aheinous/usb_hexaphonic_soundcard/media/PCB_top_1.png

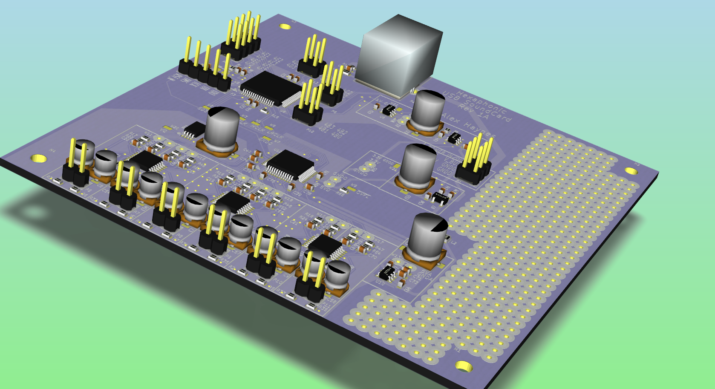
media/PCB_top_1.png
