aheinous/usb_hexaphonic_soundcard/media/PCB_bottom.png

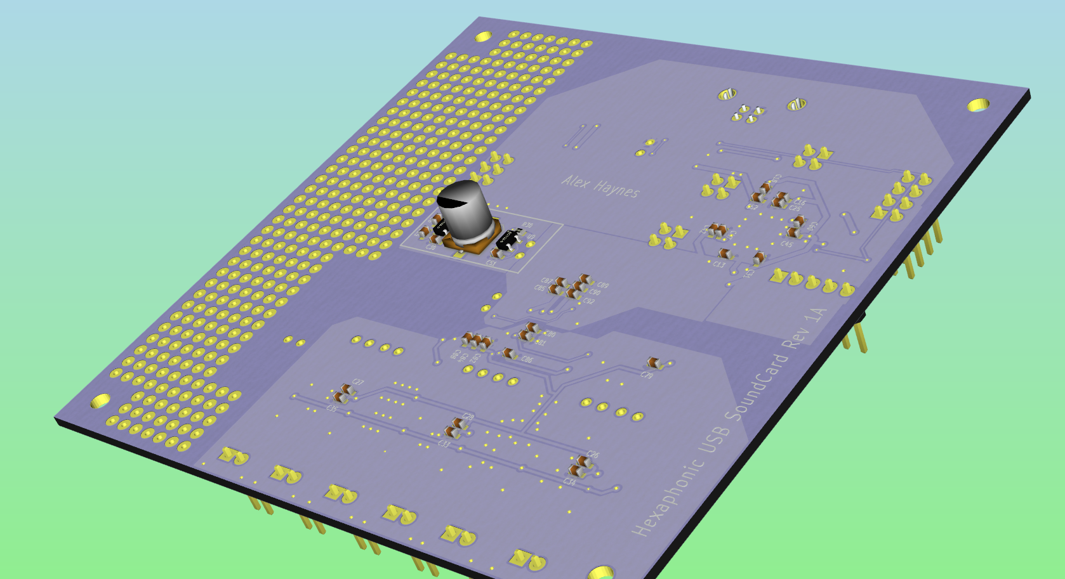
media/PCB_bottom.png
