aheinous/usb_hexaphonic_soundcard/media/PCB_top_0.png

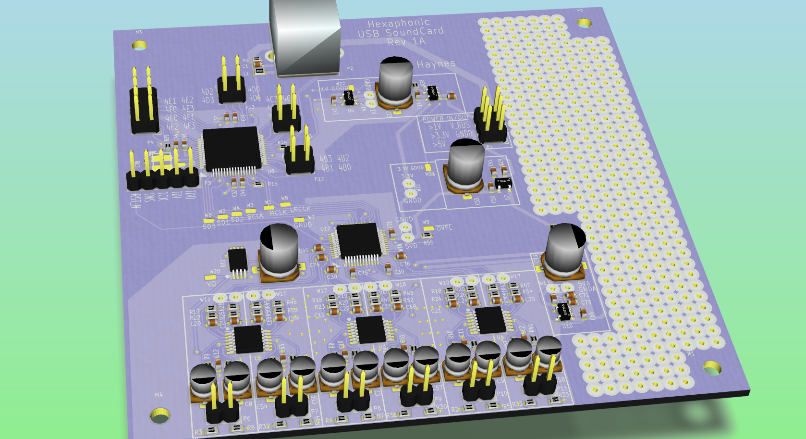
media/PCB_top_0.png
