aheinous/usb_hexaphonic_soundcard/media/PCB_top_2.png

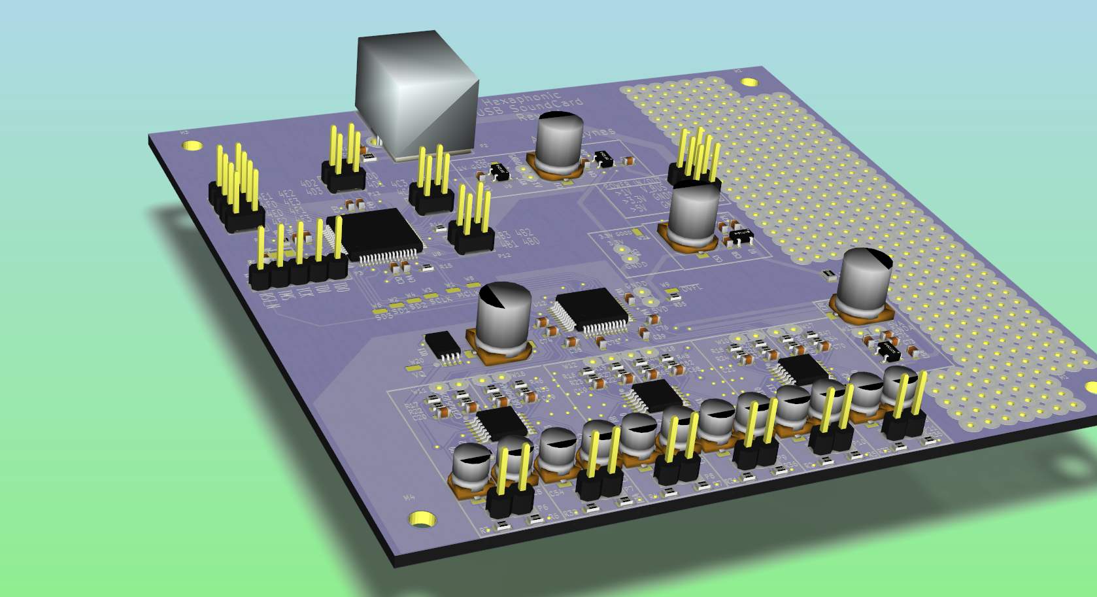
media/PCB_top_2.png
