aheinous/usb_hexaphonic_soundcard/media/schematic.pdf

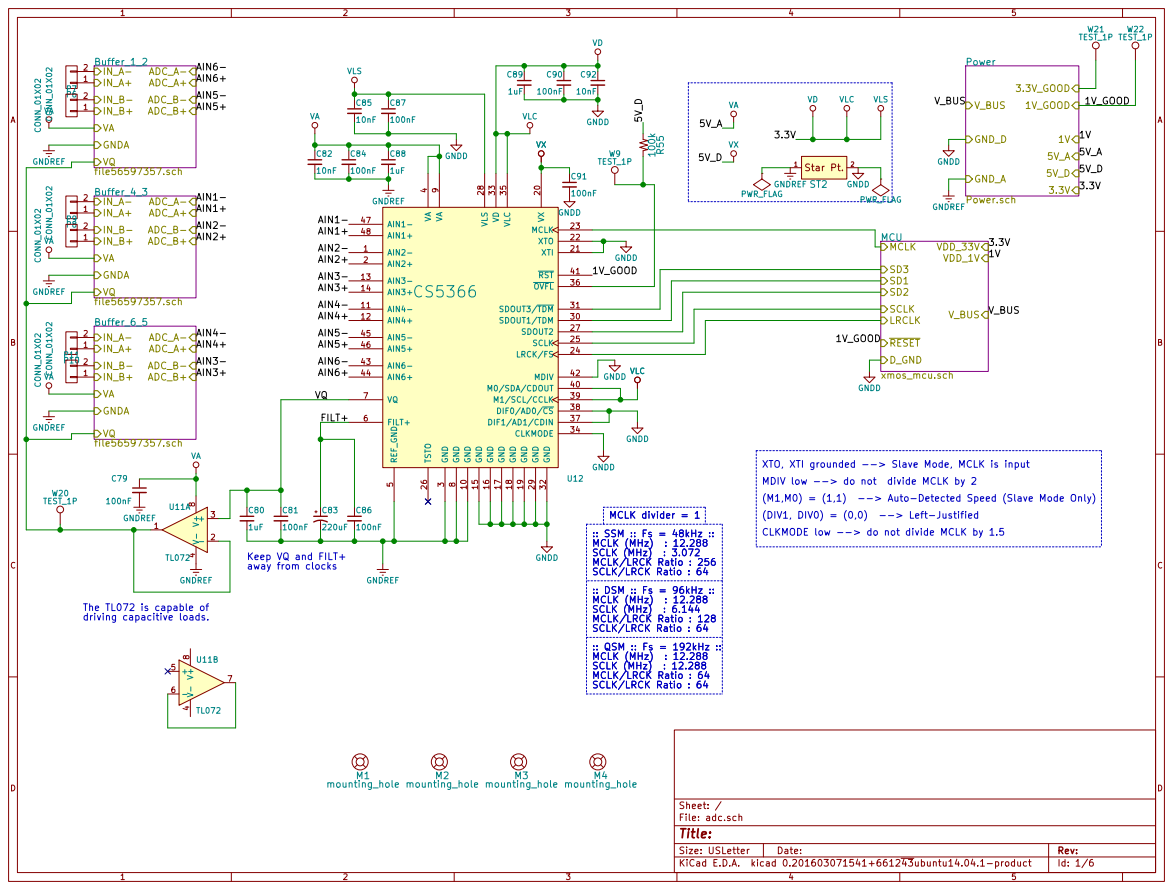
[picture p5: page 1]

9 GND 10 VX 20 SDOUT1/TDM 30 M0/SDA/CDOUT 40 AIN4- 11 XTI 21 SDOUT3/TDM 31 RST 41 AIN4+ 12 XTO 22 GND 32 MDIV 42 AIN3- 13 MCLK 23 VD 33 AIN6- 43 AIN3+ 14

(M1,M0) = (1,1) --> Auto-Detected Speed (Slave Mode Only)
(DIV1, DIV0) = (0,0) --> Left-Justified

MCLK (MHz) : 12.288 MCLK (MHz) : 12.288 SCLK (MHz) : 3.072 SCLK (MHz) : 3.072 MCLK/LRCK Ratio : 256 MCLK/LRCK Ratio : 256 SCLK/LRCK Ratio : 64 SCLK/LRCK Ratio : 64

Keep VQ and FILT+
away from clocks

MCLK (MHz) : 12.288 MCLK (MHz) : 12.288 SCLK (MHz) : 6.144 SCLK (MHz) : 6.144 MCLK/LRCK Ratio : 128 MCLK/LRCK Ratio : 128 SCLK/LRCK Ratio : 64 SCLK/LRCK Ratio : 64

The TL072 is capable of
driving capacitive loads.

MCLK (MHz) : 12.288 MCLK (MHz) : 12.288 SCLK (MHz) : 12.288 SCLK (MHz) : 12.288 MCLK/LRCK Ratio : 64 MCLK/LRCK Ratio : 64 SCLK/LRCK Ratio : 64 SCLK/LRCK Ratio : 64

Id: 1/6 Title: File: adc.sch Sheet: /

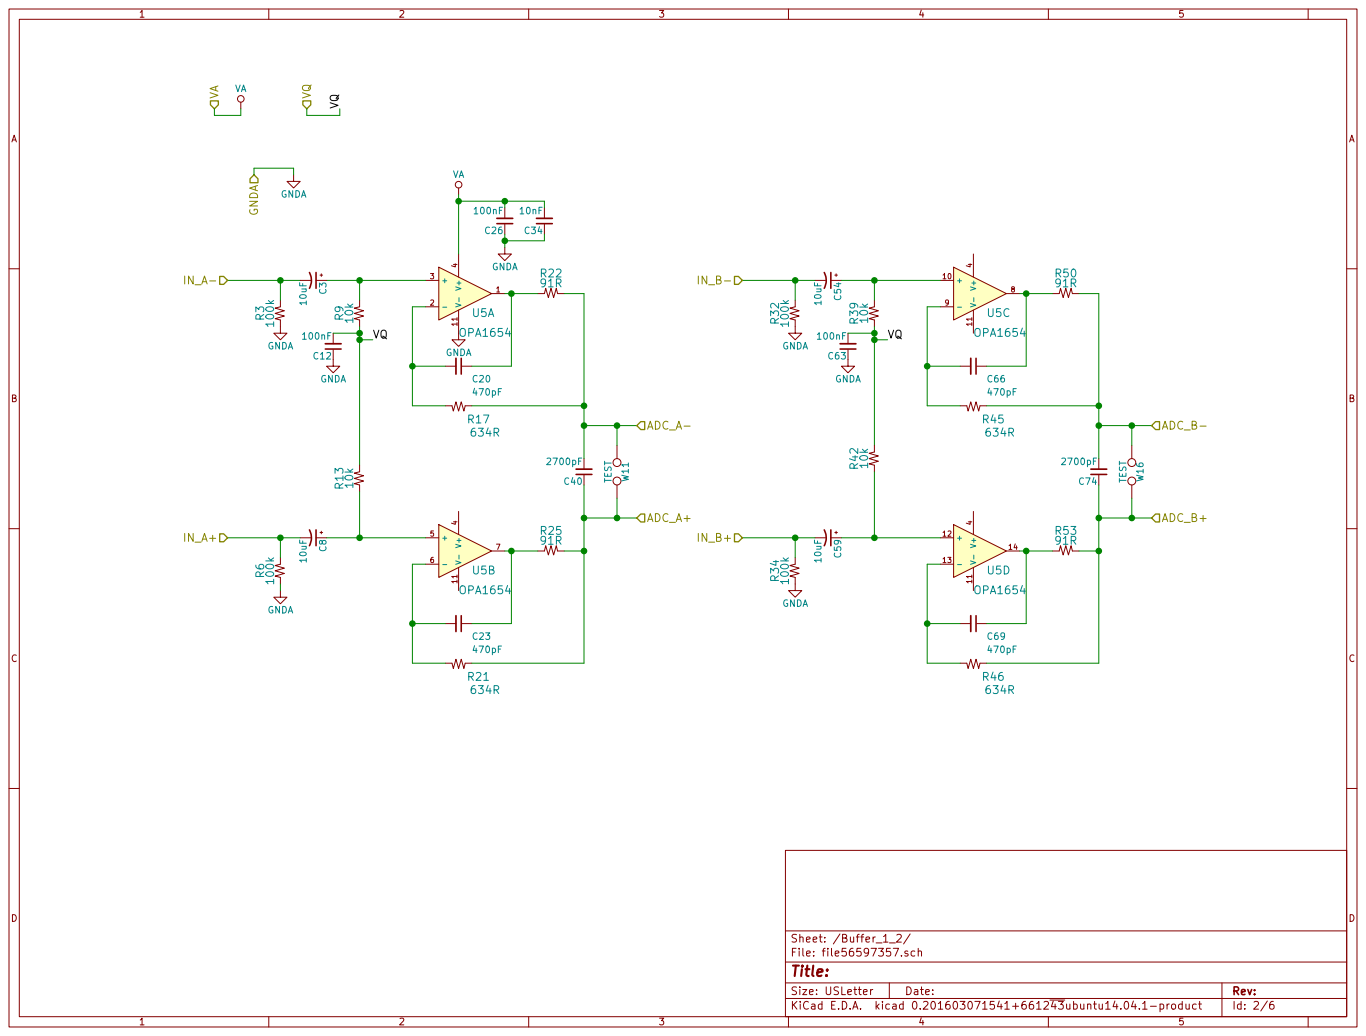
[picture p6: page 2]

Id: 2/6 Title: File: file56597357.sch Sheet: /Buffer_1_2/

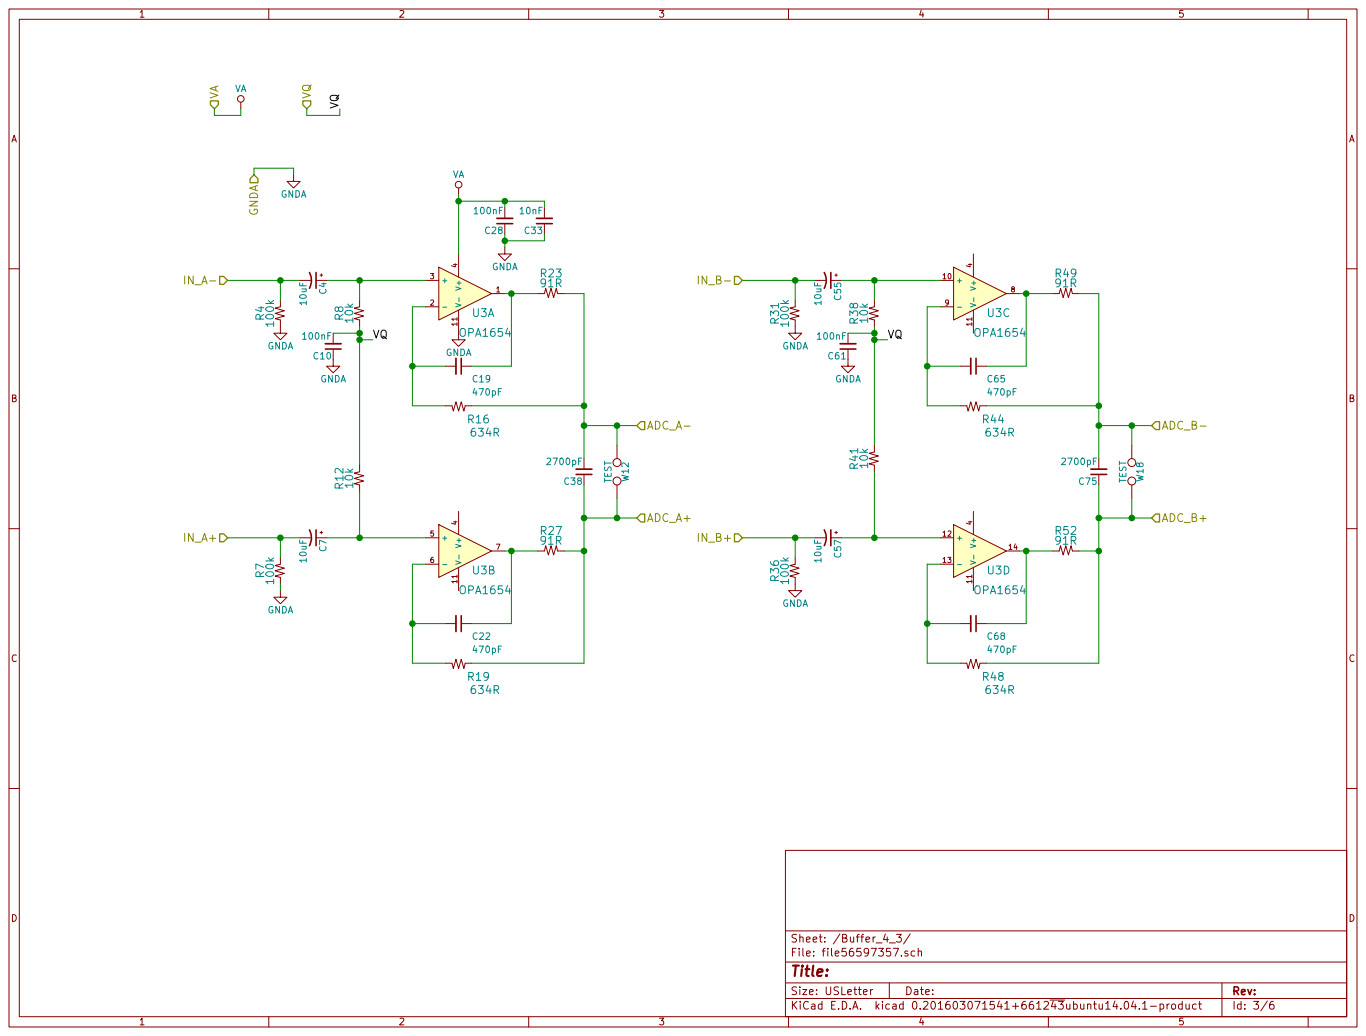
[picture p7: page 3]

Id: 3/6 Title: File: file56597357.sch Sheet: /Buffer_4_3/

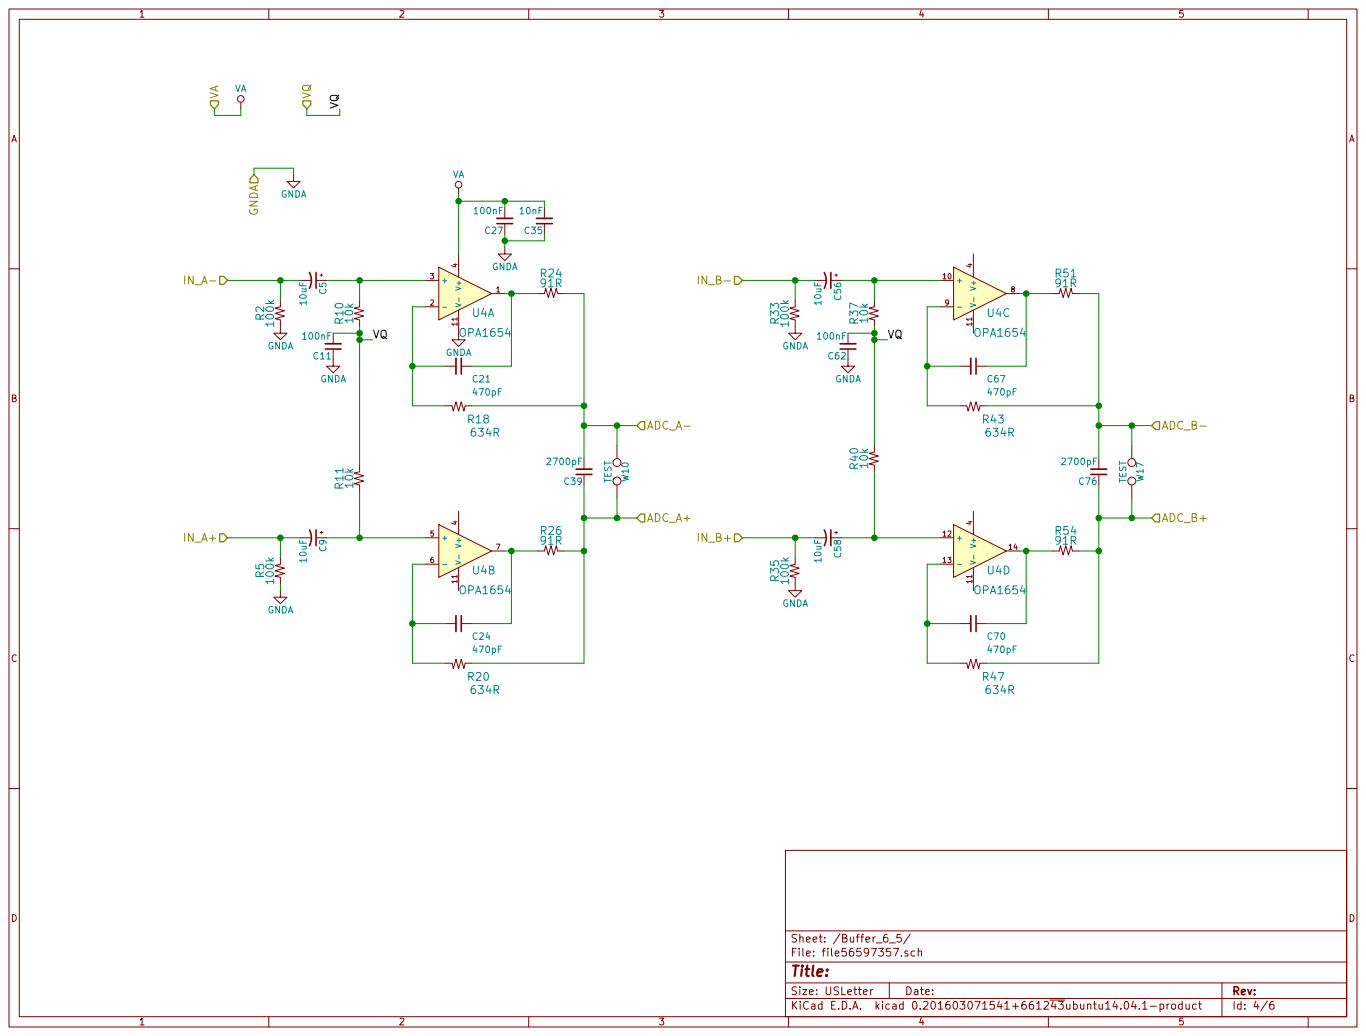
[picture p8: page 4]

Id: 4/6 Title: File: file56597357.sch Sheet: /Buffer_6_5/

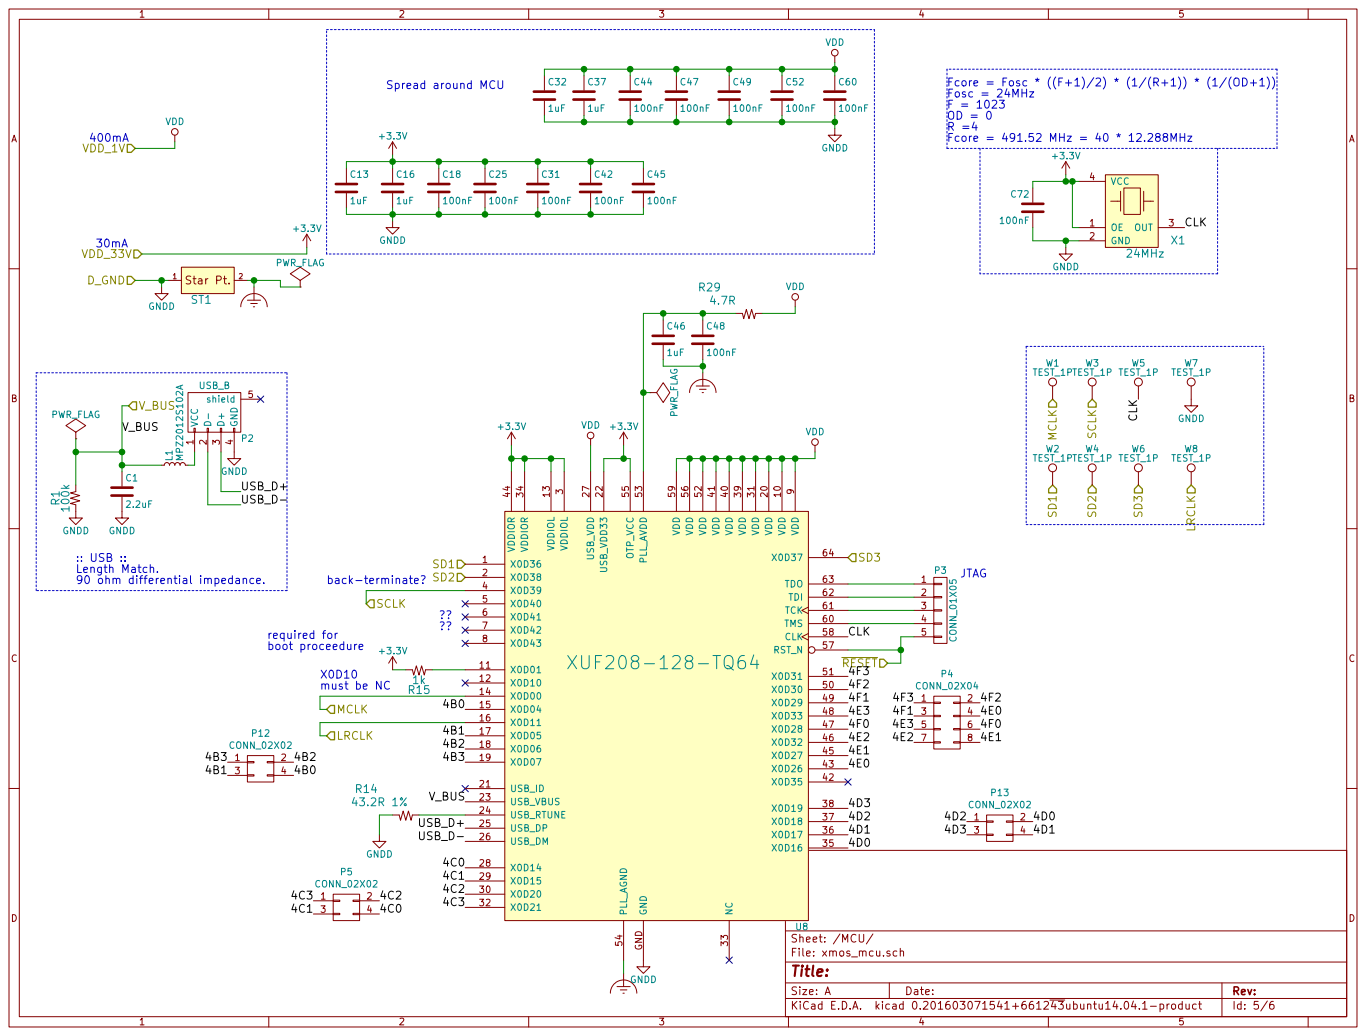
[picture p9: page 5]

Fcore = Fosc * ((F+1)/2) * (1/(R+1)) * (1/(OD+1)) Fosc = 24MHz F = 1023 OD = 0 R =4 Fcore = 491.52 MHz = 40 * 12.288MHz

9 VDD 10 VDD 20 X0D20 30 VDD 40 X0D30 50 TMS 60 X0D01 11 USB_ID 21 VDD 31 VDD 41 X0D31 51 TCK 61 X0D10 12 USB_VDD33 22 X0D21 32 X0D35 42 VDD 52 TDI 62 VDDIOL 13 USB_VBUS 23 NC 33 X0D26 43 PLL_AVDD 53 TDO 63 X0D00 14 USB_RTUNE 24 VDDIOR 34 VDDIOR 44 PLL_AGND 54 X0D37 64 X0D04 15 USB_DP 25 X0D16 35 X0D27 45 OTP_VCC 55 X0D11 16 USB_DM 26 X0D17 36 X0D32 46 VDD 56 X0D05 17 USB_VDD 27 X0D18 37 X0D28 47 RST_N 57 X0D06 18 X0D14 28 X0D19 38 X0D33 48 CLK 58 X0D07 19 X0D15 29 VDD 39 X0D29 49 VDD 59 GND GND

File: xmos_mcu.sch Sheet: /MCU/ R15

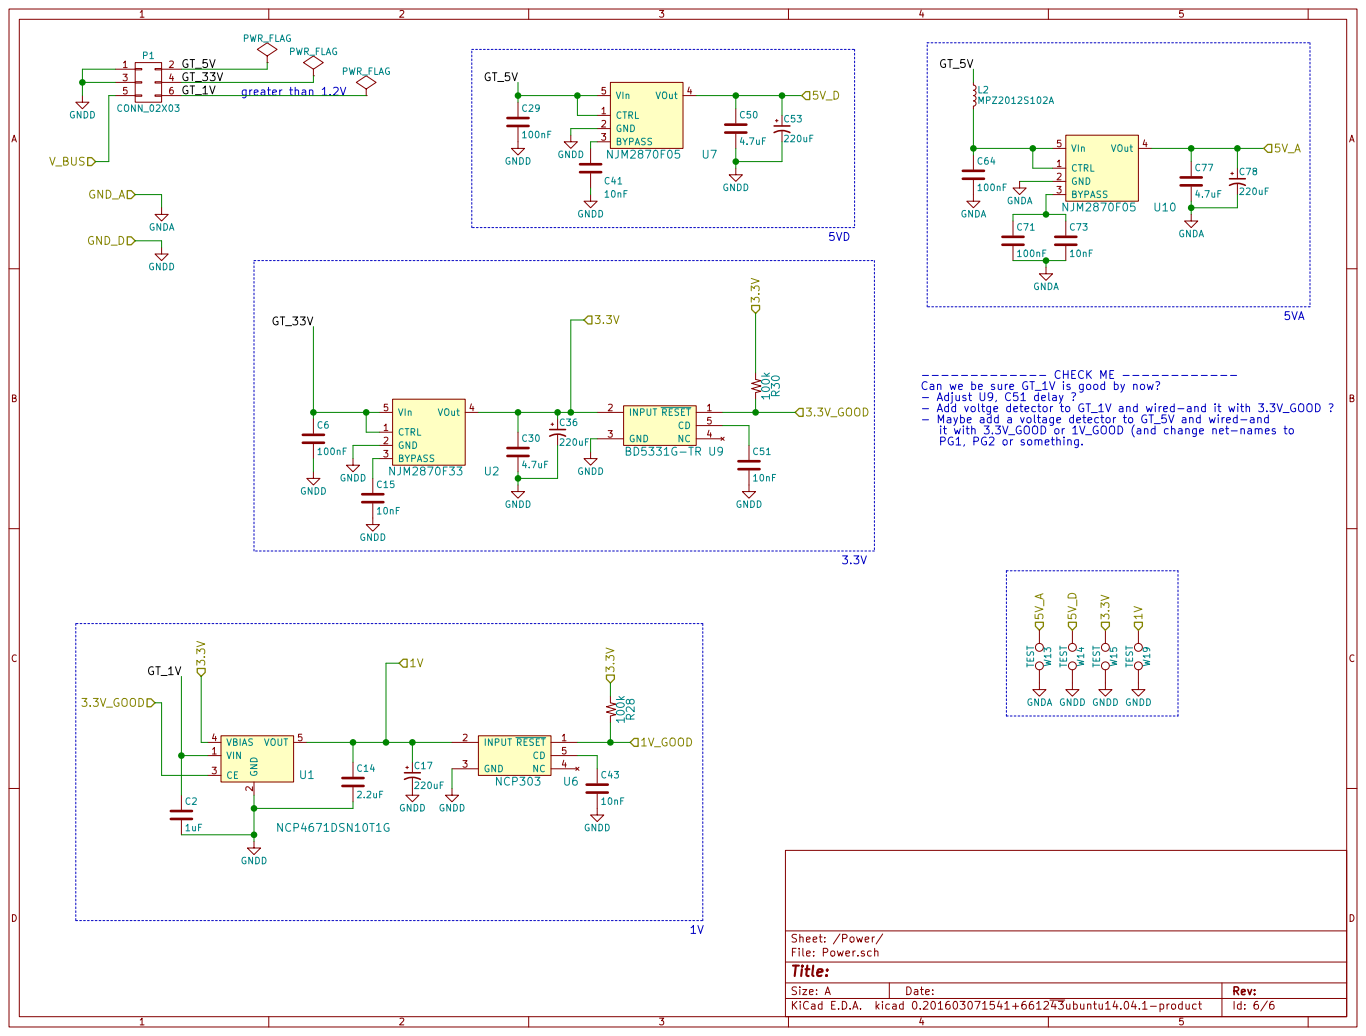
[picture p10: page 6]

greater than 1.2V

------------- CHECK ME ------------
Can we be sure GT_1V is good by now?
- Adjust U9, C51 delay ?
- Add voltge detector to GT_1V and wired-and it with 3.3V_GOOD ?
- Maybe add a voltage detector to GT_5V and wired-and
it with 3.3V_GOOD or 1V_GOOD (and change net-names to
PG1, PG2 or something.

Id: 6/6 Title: File: Power.sch Sheet: /Power/
