aheinous/usb_hexaphonic_soundcard/usb_hexaphoinc_soundcard_kicad/adc.kicad_pcb

## KiCad design usb_hexaphoinc_soundcard_kicad/adc.kicad_pcb (2016-03-05)

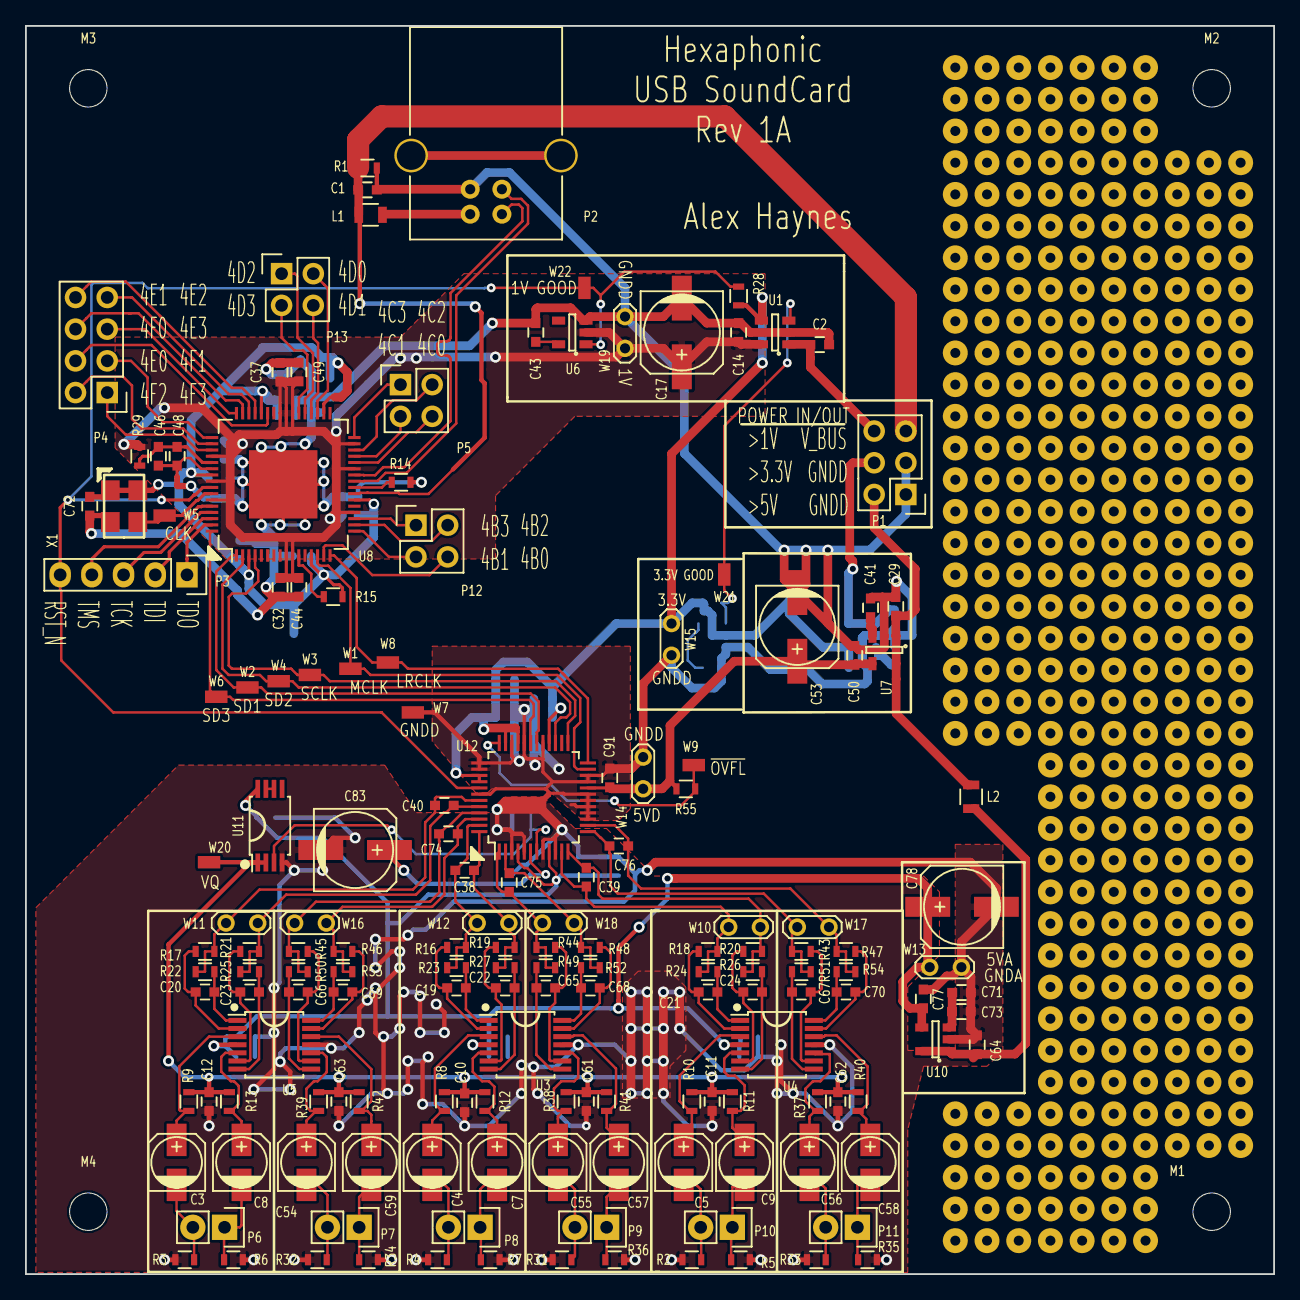
[picture p11: board adc.kicad_pcb from above]

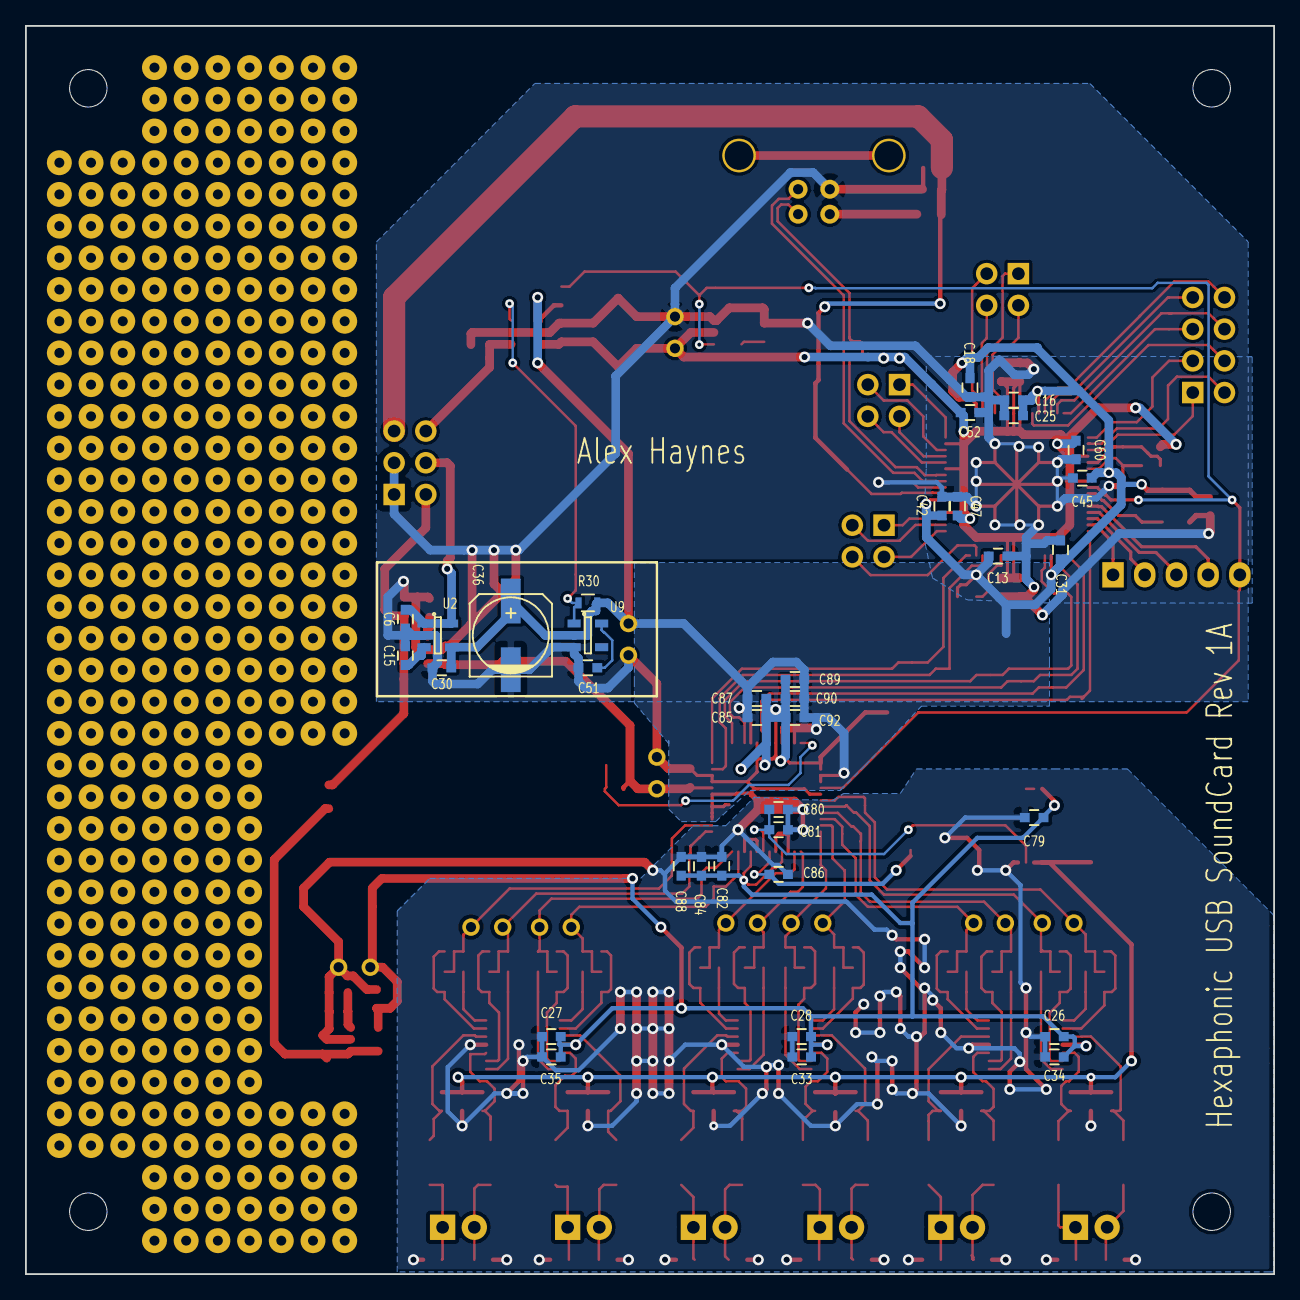
[picture p12: board adc.kicad_pcb from below]

Board: 2 copper layers, 100.0 x 100.0 mm, 203 parts (36 on the bottom side), 121 nets.

Parts:
C1, C14: 2.2uF; C_0603
C2, C13, C16, C32, C37, C46, C80, C88, C89: 1uF; C_0603
C3, C4, C5, C7, C8, C9, C54, C55, C56, C57, C58, C59: 10uF; c_elec_4x4.5
C6, C10, C11, C12, C18, C25, C26, C27, C28, C29, C31, C42, C44, C45, C47, C48, C49, C52, C60, C61, C62, C63, C64, C71, C72, C79, C81, C84, C86, C87, C90, C91: 100nF; C_0603
C15, C33, C34, C35, C41, C43, C51, C73, C82, C85, C92: 10nF; C_0603
C17, C36, C53, C78, C83: 220uF; c_elec_6.3x7.7
C19, C20, C21, C22, C23, C24, C65, C66, C67, C68, C69, C70: 470pF; C_0603
C30, C50, C77: 4.7uF; C_0603
C38, C39, C40, C74, C75, C76: 2700pF; C_0603
L1, L2: MPZ2012S102A; R_0805
M1, M2, M3, M4: mounting_hole; MountingHole_3mm
P1: CONN_02X03; Pin_Header_Straight_2x03
P2: USB_B
P3: CONN_01X05; Pin_Header_Straight_1x05
P4: CONN_02X04; Pin_Header_Straight_2x04
P5, P12, P13: CONN_02X02; Pin_Header_Straight_2x02
P6, P7, P8, P9, P10, P11: CONN_01X02; Pin_Header_Straight_1x02
R1, R2, R3, R4, R5, R6, R7, R28, R30, R31, R32, R33, R34, R35, R36, R55: 100k; R_0603
R8, R9, R10, R11, R12, R13, R37, R38, R39, R40, R41, R42: 10k; R_0603
R14: 43.2R 1%; R_0603
R15: 1k; R_0603
R16, R17, R18, R19, R20, R21, R43, R44, R45, R46, R47, R48: 634R; R_0603
R22, R23, R24, R25, R26, R27, R49, R50, R51, R52, R53, R54: 91R; R_0603
R29: 4.7R; R_0603
ST1: star_pt; star_connect_2
ST2: star_pt_2; star_connect_2
U1: NCP4671DSN10T1G; SOT-23-5
U2: NJM2870F33; SOT-23-5
U3, U4, U5: OPA1654; TSSOP-14_4.4x5mm_Pitch0.65mm_better
U6: NCP303; SOT-23-5
U7, U10: NJM2870F05; SOT-23-5
U8: XUF208-128-TQ64; LQFP-64_10x10mm_Pitch0.5mm_center_pad
U9: BD5331G-TR; SOT-23-5
U11: TL072; TSSOP-8_4.4x3mm_Pitch0.65mm_better
U12: CS5366; LQFP-48_7x7mm_Pitch0.5mm_better
W1, W2, W3, W4, W5, W6, W7, W8, W9, W20, W21, W22: TEST_1P; test_point_harwin_S2761-46R
W10, W11, W12, W13, W14, W15, W16, W17, W18, W19: TEST; Test_Point_2Pads
X1: 24MHz; SG5032_crystal_oscillator

Connections:
+3V3: C13.1, C16.1, C18.1, C25.1, C30.1, C31.1, C36.1, C42.1, C45.1, C72.1, C85.1, C87.1, C89.1, C90.1, C92.1, R15.2, R28.1, R30.1, U1.4, U2.4, U8.3, U8.13, U8.22, U8.34, U8.44, U8.55, U9.2, U12.28, U12.33, U12.35, U12.39, U12.40, W15.1, X1.1, X1.4
/Buffer_1_2/ADC_A+: C40.1, R21.1, R25.2, U12.44, W11.2
/Buffer_1_2/ADC_A-: C40.2, R17.1, R22.2, U12.43, W11.1
/Buffer_1_2/ADC_B+: C74.1, R46.1, R53.2, U12.46, W16.2
/Buffer_1_2/ADC_B-: C74.2, R45.1, R50.2, U12.45, W16.1
/Buffer_1_2/IN_A+: C8.2, P6.1, R6.2
/Buffer_1_2/IN_A-: C3.2, P6.2, R3.2
/Buffer_1_2/IN_B+: C59.2, P7.1, R34.2
/Buffer_1_2/IN_B-: C54.2, P7.2, R32.2
/Buffer_1_2/VQ: C10.2, C11.2, C12.2, C61.2, C62.2, C63.2, R8.1, R9.1, R10.1, R11.2, R12.2, R13.2, R37.1, R38.1, R39.1, R40.2, R41.2, R42.2, U11.1, U11.2, W20.1
/Buffer_4_3/ADC_A+: C38.1, R19.1, R27.2, U12.48, W12.2
/Buffer_4_3/ADC_A-: C38.2, R16.1, R23.2, U12.47, W12.1
/Buffer_4_3/ADC_B+: C75.1, R48.1, R52.2, U12.2, W18.2
/Buffer_4_3/ADC_B-: C75.2, R44.1, R49.2, U12.1, W18.1
/Buffer_4_3/IN_A+: C7.2, P8.1, R7.2
/Buffer_4_3/IN_A-: C4.2, P8.2, R4.2
/Buffer_4_3/IN_B+: C57.2, P9.1, R36.2
/Buffer_4_3/IN_B-: C55.2, P9.2, R31.2
/Buffer_6_5/ADC_A+: C39.1, R20.1, R26.2, U12.12, W10.2
/Buffer_6_5/ADC_A-: C39.2, R18.1, R24.2, U12.11, W10.1
/Buffer_6_5/ADC_B+: C76.1, R47.1, R54.2, U12.14, W17.2
/Buffer_6_5/ADC_B-: C76.2, R43.1, R51.2, U12.13, W17.1
/Buffer_6_5/IN_A+: C9.2, P10.1, R5.2
/Buffer_6_5/IN_A-: C5.2, P10.2, R2.2
/Buffer_6_5/IN_B+: C58.2, P11.1, R35.2
/Buffer_6_5/IN_B-: C56.2, P11.2, R33.2
/FILT+: C83.1, C86.1, U12.6
/MCU/4B0: P12.4, U8.15
/MCU/4B1: P12.3, U8.17
/MCU/4B2: P12.2, U8.18
/MCU/4B3: P12.1, U8.19
/MCU/4C0: P5.4, U8.28
/MCU/4C1: P5.3, U8.29
/MCU/4C2: P5.2, U8.30
/MCU/4C3: P5.1, U8.32
/MCU/4D0: P13.2, U8.35
/MCU/4D1: P13.4, U8.36
/MCU/4D2: P13.1, U8.37
/MCU/4D3: P13.3, U8.38
/MCU/4E0: P4.4, U8.43
/MCU/4E1: P4.8, U8.45
/MCU/4E2: P4.7, U8.46
/MCU/4E3: P4.5, U8.48
/MCU/4F0: P4.6, U8.47
/MCU/4F1: P4.3, U8.49
/MCU/4F2: P4.2, U8.50
/MCU/4F3: P4.1, U8.51
/MCU/CLK: U8.58, W5.1, X1.3
/MCU/LRCLK: U8.16, U12.24, W8.1
/MCU/MCLK: U8.14, U12.23, W1.1
/MCU/SCLK: U8.4, U12.25, W3.1
/MCU/SD1: U8.1, U12.30, W2.1
/MCU/SD2: U8.2, U12.27, W4.1
/MCU/SD3: U8.64, U12.31, W6.1
/MCU/USB_D+: P2.3, U8.25
/MCU/USB_D-: P2.2, U8.26
/MCU/V_BUS: C1.1, L1.1, P1.5, R1.2, U8.23
/Power/1V_GOOD: P3.5, R28.2, U6.1, U8.57, U12.41, W22.1
/Power/3.3V_GOOD: R30.2, U1.3, U9.1, W21.1
/Power/GT_1V: C2.1, P1.6, U1.1
/Power/GT_5V: C29.1, L2.1, P1.2, U7.1, U7.5
/Power/GT_33V: C6.1, P1.4, U2.1, U2.5
/VQ: C80.1, C81.1, U11.3, U12.7
Earth_Clean: C46.2, C48.2, ST1.2, U8.54
GNDA: C10.1, C11.1, C12.1, C26.1, C27.1, C28.1, C33.1, C34.1, C35.1, C61.1, C62.1, C63.1, C64.2, C71.2, C73.2, C77.2, C78.2, C79.2, C80.2, C81.2, C82.2, C83.2, C84.2, C86.2, C88.2, R2.1, R3.1, R4.1, R5.1, R6.1, R7.1, R31.1, R32.1, R33.1, R34.1, R35.1, R36.1, ST2.1, U3.11, U4.11, U5.11, U10.2, U11.4, U12.3, U12.5, U12.8, U12.10, W13.2
GNDD: C1.2, C2.2, C6.2, C13.2, C14.2, C15.2, C16.2, C17.2, C18.2, C25.2, C29.2, C30.2, C31.2, C32.2, C36.2, C37.2, C41.2, C42.2, C43.2, C44.2, C45.2, C47.2, C49.2, C50.2, C51.2, C52.2, C53.2, C60.2, C72.2, C85.2, C87.2, C89.2, C90.2, C91.2, C92.2, P1.1, P1.3, P2.4, R1.1, R14.2, ST1.1, ST2.2, U1.2, U2.2, U6.3, U7.2, U8.GND, U9.3, U12.15, U12.16, U12.17, U12.18, U12.19, U12.21, U12.22, U12.29, U12.32, U12.34, U12.37, U12.38, U12.42, W7.1, W14.2, W15.2, W19.2, X1.2
unnamed: C3.1, R9.2, U5.3
unnamed: C4.1, R8.2, U3.3
unnamed: C5.1, R10.2, U4.3
unnamed: C7.1, R12.1, U3.5
unnamed: C8.1, R13.1, U5.5
unnamed: C9.1, R11.1, U4.5
unnamed: C15.1, U2.3
unnamed: C19.1, R23.1, U3.1
unnamed: C19.2, R16.2, U3.2
unnamed: C20.1, R22.1, U5.1
unnamed: C20.2, R17.2, U5.2
unnamed: C21.1, R24.1, U4.1
unnamed: C21.2, R18.2, U4.2
unnamed: C22.1, R27.1, U3.7
unnamed: C22.2, R19.2, U3.6
unnamed: C23.1, R25.1, U5.7
unnamed: C23.2, R21.2, U5.6
unnamed: C24.1, R26.1, U4.7
unnamed: C24.2, R20.2, U4.6
unnamed: C41.1, U7.3
unnamed: C43.1, U6.5
unnamed: C46.1, C48.1, R29.2, U8.53
unnamed: C51.1, U9.5
unnamed: C54.1, R39.2, U5.10
unnamed: C55.1, R38.2, U3.10
unnamed: C56.1, R37.2, U4.10
unnamed: C57.1, R41.1, U3.12
unnamed: C58.1, R40.1, U4.12
unnamed: C59.1, R42.1, U5.12
unnamed: C64.1, L2.2, U10.1, U10.5
unnamed: C65.1, R49.1, U3.8
unnamed: C65.2, R44.2, U3.9
unnamed: C66.1, R50.1, U5.8
unnamed: C66.2, R45.2, U5.9
unnamed: C67.1, R51.1, U4.8
unnamed: C67.2, R43.2, U4.9
unnamed: C68.1, R52.1, U3.14
unnamed: C68.2, R48.2, U3.13
unnamed: C69.1, R53.1, U5.14
unnamed: C69.2, R46.2, U5.13
unnamed: C70.1, R54.1, U4.14
unnamed: C70.2, R47.2, U4.13
unnamed: C71.1, C73.1, U10.3
unnamed: L1.2, P2.1
unnamed: P3.1, U8.63
unnamed: P3.2, U8.62
unnamed: P3.3, U8.61
unnamed: P3.4, U8.60
unnamed: R14.1, U8.24
unnamed: R15.1, U8.11
unnamed: R55.2, U12.36, W9.1
unnamed: U11.6, U11.7
VA: C26.2, C27.2, C28.2, C33.2, C34.2, C35.2, C77.1, C78.1, C79.1, C82.1, C84.1, C88.1, U3.4, U4.4, U5.4, U10.4, U11.8, U12.4, U12.9, W13.1
VDD: C14.1, C17.1, C32.1, C37.1, C44.1, C47.1, C49.1, C52.1, C60.1, R29.1, U1.5, U6.2, U8.9, U8.10, U8.20, U8.27, U8.31, U8.39, U8.40, U8.41, U8.52, U8.56, U8.59, W19.1
VX: C50.1, C53.1, C91.1, R55.1, U7.4, U12.20, W14.1
