aheinous/usb_hexaphonic_soundcard/(commit log)

2016-03-05 Initial Commit.
    Initial design complete but not tested.
    [Power.sch, adc.kicad_pcb, adc.sch, file56597357.sch, file565F5A2E.sch, file565F5A2F.sch, file565F5A30.sch, noname.kicad_pcb]
2016-03-08 Added media.
    Added PDFs of schematic and PNGs of board.
    [Power.sch, noname.kicad_pcb]
